davimaltez/ProjetoAPG/esquema_circuito/circuito.png

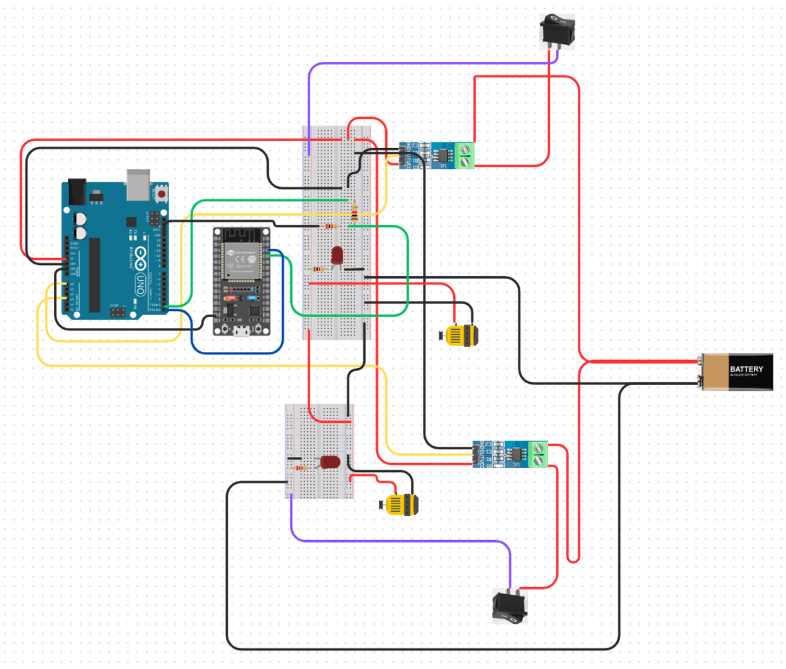
esquema_circuito/circuito.png
