davimaltez/ProjetoAPG/(commit log)

2025-12-09 add esp and arduino codes
2025-12-10 add
    add circuito.png and uptade readme.md
2025-12-10 Update README with CallMeBot integration and ESP32 code
    Added optional integration instructions for CallMeBot and updated ESP32 code variables.
